kurumada-atsushi/edison-board/README.md

# edison-board

ディレクトリ構成は以下の通り

■eagle-lbr</BR>
 →基板に使用したオリジナルの部品ライブラリ

■parts-list</BR>
 →使用した部品のリスト
 
■Schematics</BR>
 →回路図
 
■Design</BR>
 →基板図(外形図、レイアウト、配線)
 
■sample-program</BR>
 →サンプルのプログラム
