kurumada-atsushi/edison-board/sample-program/Readme.md

※本サンプルプログラムは、Intel Edison(ublinux版)にmraaライブラリをインストールしている前提で、
I2Cバスに接続された温度センサーからの読み出しを行っています。

■i2ctest.c
→Cプログラム

■adt7410.py
→Pythonプログラム

・I2Cバスのアドレス確認方法
i2cバスの状況を確認するツールがあるのでそれを利用

<code>
apt-get install i2c-tools
</code>
ツールを入れたら以下のコマンドを実行

<code>
i2cdetect -y 1
</code>

コマンドを実行すると、下のような結果が返ってくる
<quote>
</br>
     0  1  2  3  4  5  6  7  8  9  a  b  c  d  e  f </br>
00:          -- -- -- -- -- -- -- -- -- -- -- -- -- </br>
10: -- -- -- -- -- -- -- -- -- -- -- -- -- -- -- -- </br>
20: -- -- -- -- -- -- -- -- -- -- -- -- -- -- -- -- </br>
30: -- -- -- -- -- -- -- -- -- -- -- -- -- -- -- -- </br>
40: -- -- -- -- -- -- -- -- 48 -- -- -- -- -- -- -- </br>
50: -- -- -- -- -- -- -- -- -- -- -- -- -- -- -- -- </br>
60: -- -- -- -- -- -- -- -- -- -- -- -- -- -- -- -- </br>
70: -- -- -- -- -- -- -- -- </br>
</quote>

→この場合、スキャンの結果として、「0x48」にデバイスが接続されている
