kurumada-atsushi/edison-board/(threads)

Thread 2 (2016-09-20):

実装部品をP板.comに送る

kurumada-atsushi, 2016-09-20:
LED：到着
その他部品：Digi-Keyより到着待ち

kurumada-atsushi, 2016-09-20:
Digi-Keyより注文部品到着！
部品リストと合わせてP板.comへの配送手配完了。
9/21配送手配済み(9/23までに到着すれば納期変更なしなので余裕あり)

kurumada-atsushi, 2016-09-21:
提供部品の宅急便引き渡し完了。
P板.comへのFAXも完了

kurumada-atsushi, 2016-09-23:
部品の受け入れまで完了の連絡あり！
本件クローズします。

Closed 2016-09-23.

Thread 3 (2016-09-20):

量産に向けた業者選定

kurumada-atsushi, 2016-09-20:
- P板.com</BR>
・プロトタイプを作った実績もあるしある意味無難
- キョウデン</BR>
・DMMとのつながり強し。本当に量産するなら、ここで治具作って実装がベターかも
- マルツ</BR>
・電子パーツの通販で有名。基板制作の他、部品実装も始めたみたい。要調査

kurumada-atsushi, 2016-09-21:
とりあえずP板.comに見積もり依頼
→パーツリストが読み込めないエラーが発生？

kurumada-atsushi, 2016-09-23:
P板に再度ファイルをお送り部品調達まで含めた見積もりを続行中

kurumada-atsushi, 2016-09-26:
部品リストを単体で送付。
P板より見積もりについて進捗あり。
```
> 上記誠にありがとうございます。
> 少々エラーが出るようですが（調査してみます）
> 開けたようですので、見積を開始しております。
```

kurumada-atsushi, 2016-09-30:
P板.com見積もり完了。
(プリント基板の薄さを半分にし、軽量化を図っている)

基板50枚、実装30(完成品は30枚ってこと)で約14万円
4,700円/枚程度。
一旦、参考の見積もりはOKとし、部品調達、製造まで一貫してできるP板がベストと結論。

Thread 4 (2016-09-20):

基板レイアウトと小型化の検討

kurumada-atsushi, 2016-09-20:
**- 部品の再選定**

- [ ] 急ぎで1608のチップ抵抗、コンデンサを選び直したが、実際には少し大きい。手実装できる範囲で再選定したい</BR>
- [ ] 今選定している部品はP板無償提供部品なので、そのまま部品は変えずに小型化に向けて動く

**- レイアウト**

- [ ] 実装基板が届いてからだけど、レイアウト的に問題ないかを確認
