kurumada-atsushi/edison-board/Schematics/edison_board.sch

## EAGLE design Schematics/edison_board.sch (2016-11-22)

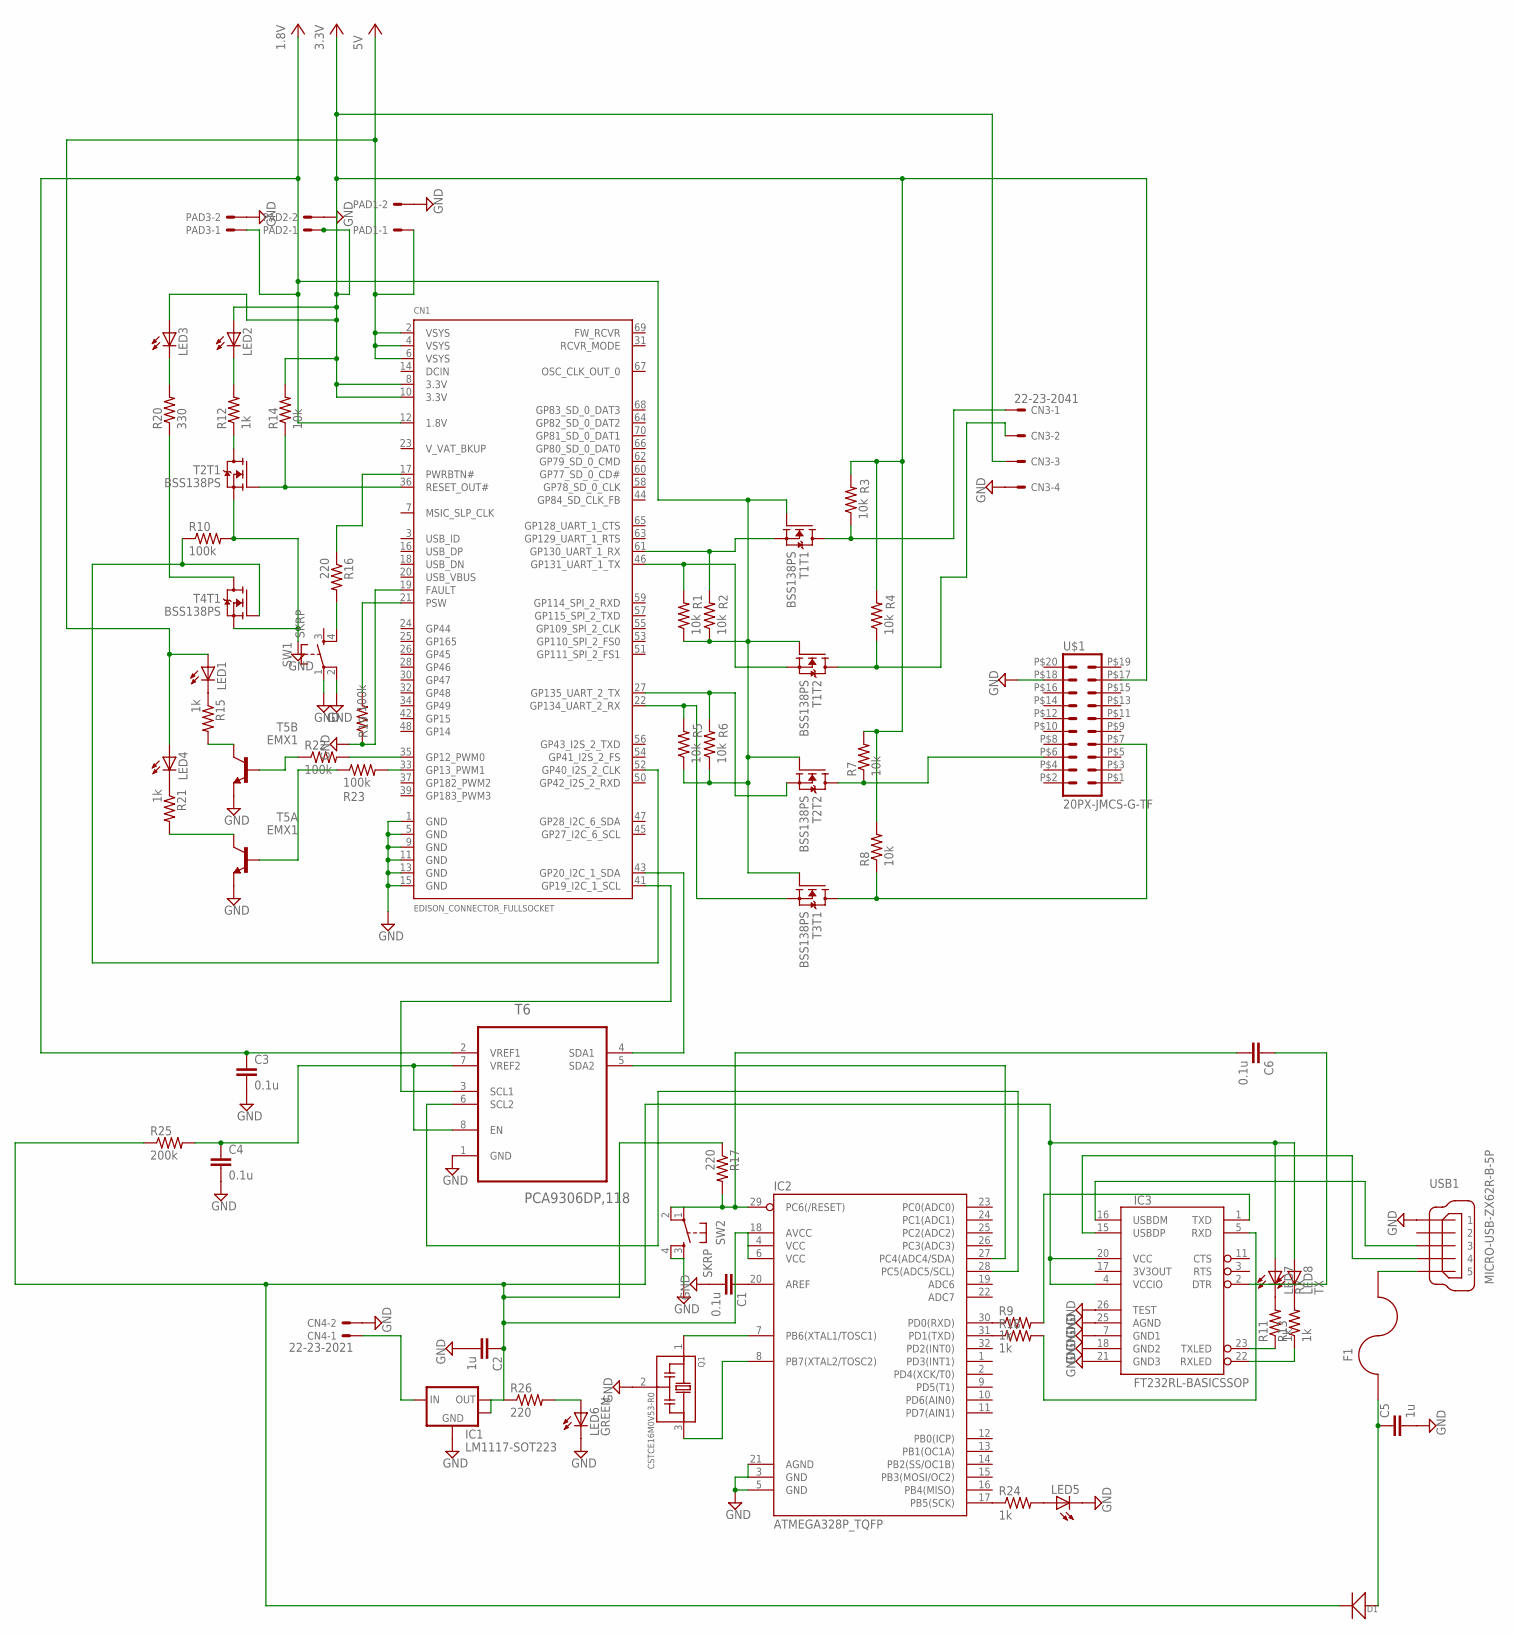
[picture p1: schematic edison_board.sch]

Parts:
C1, C3, C4, C6: 0.1u; C0603
C2, C5: 1u; C0603
CN1: EDISON_CONNECTOR_FULLSOCKET; DF40-XC-(X.X)-70DS-0.4V(51)
CN3: 22-23-2041
CN4: 22-23-2021
D1: D'DO-220AA'; DO-220AA
F1: MF-MSMF075/24; 1812
IC1: LM1117-SOT223; SOT-223-3
IC2: ATMEGA328P_TQFP; TQFP32-08
IC3: FT232RL-BASICSSOP; SSOP28DB
LED1, LED2, LED3, LED4, LED5: LEDCHIPLED_1206; CHIPLED_1206
LED6: GREEN; CHIPLED_1206
LED7: RX; CHIPLED_1206
LED8: TX; CHIPLED_1206
PAD1, PAD2, PAD3: 87758-0216
Q1: CSTCE16M0V53-R0; OSC_CSTCE16M0V53-R0
R1, R2, R3, R4, R5, R6, R7, R8, R14: 10k; R0603
R9, R11, R12, R13, R15, R18, R21, R24: 1k; R0603
R10, R19, R22, R23: 100k; R0603
R16, R17, R26: 220; R0603
R20: 330; R0603
R25: 200k; R0603
SW1, SW2: SKRP
T1, T2, T3, T4: BSS138PS; SOT363
T5: EMX1; EMT6
T6: PCA9306DP,118; SOP65P490X110-8N
U$1: 20PX-JMCS-G-TF
USB1: MICRO-USB-ZX62R-B-5P; ZX62R-B-5P

Connections:
GND: C1.2, C2.2, C3.2, C4.2, C5.2, CN1.1 (GND), CN1.5 (GND), CN1.9 (GND), CN1.11 (GND), CN1.13 (GND), CN1.15 (GND), CN1.19 (FAULT), CN3.4, CN4.2, IC1.1 (GND), IC2.3 (GND), IC2.5 (GND), IC2.21 (AGND), IC3.7 (GND1), IC3.18 (GND2), IC3.21 (GND3), IC3.25 (AGND), IC3.26 (TEST), LED5.C, LED6.C, PAD1.2, PAD2.2, PAD3.2, Q1.2, R10.2, R19.1, SW1.1, SW1.2, SW2.3, SW2.4, T2.1 (S), T4.1 (S), T5.1 (E), T5.4 (E), T6.1 (GND), U$1.P$18 (18), USB1.1
IC2: C6.1, IC3.2 (DTR)
unnamed: CN1.61 (GP130_UART_1_RX), R2.2, T1.1 (S)
unnamed: CN1.46 (GP131_UART_1_TX), R1.2, T1.4 (S)
unnamed: CN3.2, R4.1, T1.3 (D)
unnamed: CN3.1, R3.1, T1.6 (D)
unnamed: IC2.7 (PB6(XTAL1/TOSC1)), Q1.1
unnamed: R7.1, T2.3 (D), U$1.P$6 (6)
unnamed: R8.1, T3.6 (D), U$1.P$7 (7)
unnamed: LED4.C, R21.1
unnamed: CN1.22 (GP134_UART_2_RX), R5.2, T3.1 (S)
unnamed: CN1.36 (RESET_OUT#), R14.1, T2.2 (G)
unnamed: C6.2, IC2.29 (PC6(/RESET)), R17.2, SW2.1, SW2.2
unnamed: LED2.C, R12.2
unnamed: R12.1, T2.6 (D)
unnamed: CN1.17 (PWRBTN#), R16.1
unnamed: CN1.52 (GP40_I2S_2_CLK), R10.1, T4.2 (G)
unnamed: R16.2, SW1.4
unnamed: R20.1, T4.6 (D)
unnamed: LED3.C, R20.2
unnamed: CN1.21 (PSW), R19.2
unnamed: LED1.C, R15.1
unnamed: R21.2, T5.6 (C)
unnamed: CN1.41 (GP19_I2C_1_SCL), T6.3 (SCL1)
unnamed: R15.2, T5.3 (C)
unnamed: R22.1, T5.5 (B)
unnamed: R23.1, T5.2 (B)
unnamed: CN1.35 (GP12_PWM0), R22.2
unnamed: CN1.33 (GP13_PWM1), R23.2
unnamed: C4.1, R25.2, T6.7 (VREF2), T6.8 (EN)
unnamed: CN1.43 (GP20_I2C_1_SDA), T6.4 (SDA1)
unnamed: IC2.28 (PC5(ADC5/SCL)), T6.6 (SCL2)
unnamed: IC2.27 (PC4(ADC4/SDA)), T6.5 (SDA2)
unnamed: IC2.8 (PB7(XTAL2/TOSC2)), Q1.3
unnamed: IC2.17 (PB5(SCK)), R24.1
unnamed: C3.1, CN1.12 (1.8V), CN1.27 (GP135_UART_2_TX), PAD3.1, R1.1, R2.1, R5.1, R6.1, R6.2, T1.2 (G), T1.5 (G), T2.4 (S), T2.5 (G), T3.2 (G), T6.2 (VREF1)
unnamed: LED5.A, R24.2
unnamed: CN1.8 (3.3V), CN1.10 (3.3V), CN3.3, LED2.A, LED3.A, PAD2.1, R3.2, R4.2, R7.2, R8.2, R14.2, U$1.P$17 (17)
unnamed: C1.1, IC2.20 (AREF)
unnamed: IC3.16 (USBDM), USB1.3
unnamed: CN4.1, IC1.3 (VIN)
unnamed: LED6.A, R26.2
unnamed: IC3.15 (USBDP), USB1.4
unnamed: F1.1, USB1.5
unnamed: C5.1, D1.+, F1.2
unnamed: CN1.2 (VSYS), CN1.4 (VSYS), CN1.6 (VSYS), LED1.A, LED4.A, PAD1.1
unnamed: IC2.30 (PD0(RXD)), R9.1
unnamed: C2.1, D1.-, IC1.2 (VOUT), IC1.4 (HEATSINK), IC2.4 (VCC), IC2.6 (VCC), IC2.18 (AVCC), IC3.4 (VCCIO), IC3.20 (VCC), LED7.A, LED8.A, R17.1, R25.1, R26.1
unnamed: IC2.31 (PD1(TXD)), R18.1
unnamed: IC3.1 (TXD), R9.2
unnamed: IC3.5 (RXD), R18.2
unnamed: IC3.23 (TXLED), R11.1
unnamed: IC3.22 (RXLED), R13.1
unnamed: LED7.C, R11.2
unnamed: LED8.C, R13.2
