kurumada-atsushi/edison-board/(commit log)

2016-09-26 commit sample i2c-read-program
    [parts_list.xls]
2016-09-26 commit python-i2c-reader
2016-09-30 add LED(with SILK)
2016-09-30 add LED library
2016-11-22 add library
    [201611140021G_parts_list161118_回答6版1121.xlsx, edison_board.sch]
